Rnagp224/Uploads/Ensamble Pergola.IGS

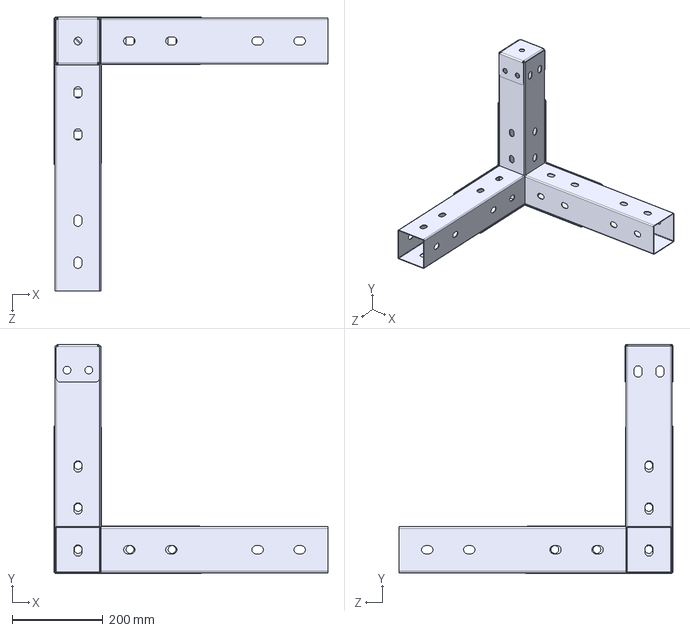
[picture p1: CAD file, 2024-05-31]
Ensamble Pergola.IGS
603.5 x 505.1 x 603.8 mm
