Rnagp224/Uploads/Agadir.STEP

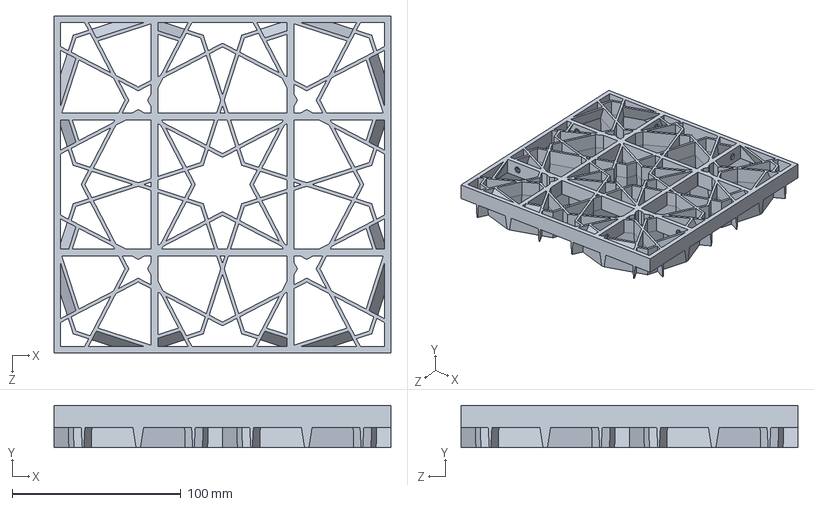
[picture p2: CAD file, 2025-08-26]
Agadir.STEP
200.0 x 25.0 x 200.0 mm
