Rnagp224/Uploads/Convexo.STEP

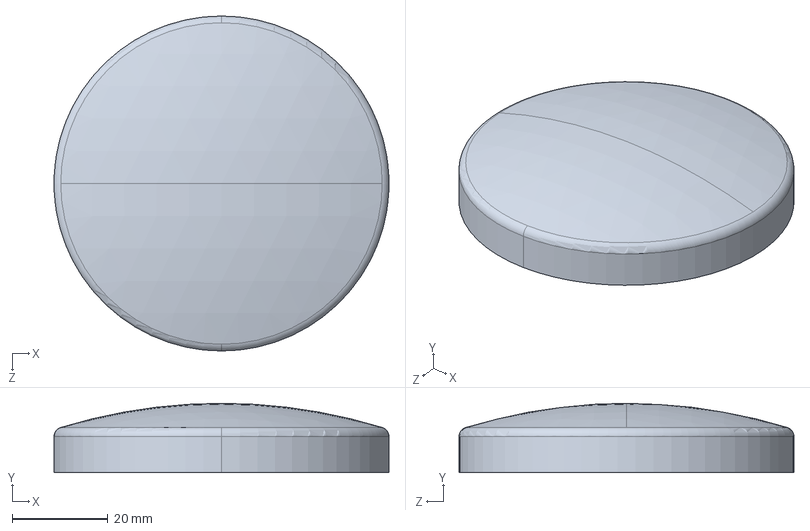
[picture p3: CAD file, 2025-03-21]
Convexo.STEP
70.0 x 14.5 x 70.0 mm
