Rnagp224/Uploads/Mesa Eaton.STEP

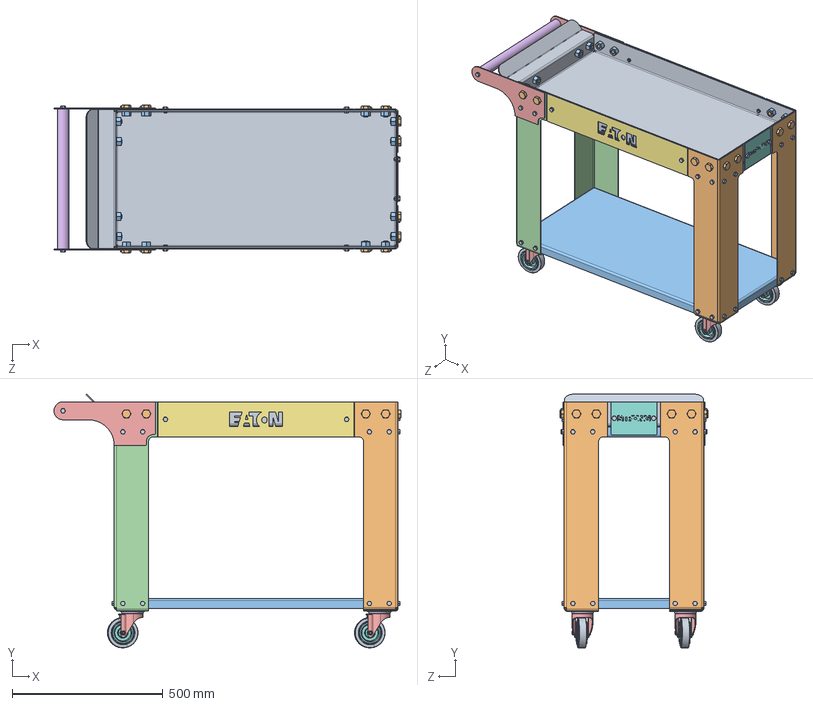
[picture p5: CAD file, 2024-09-07]
Mesa Eaton.STEP
1152.9 x 842.7 x 491.0 mm
Charola 1
Pata Eaton x 2
Charola3_Calibre 14
Top Plate x 4
Yoke x 4
Seal x 4
641028x55 x 4
Wheel 4in x 4
nut_din_985-m8x1_25-8 x 4
Charola2_Calibre 14
Pata Eaton_Trasera
MirrorPata Eaton_Trasera
Jalador x 2
Barra_Default<As Machined>
Placa Eaton x 2
Strong
hex bolt_ai_HBOLT 0.3750-16x0.5x0.5-C x 40
heavy hex finished bolt_ai_HHFBOLT 0.6250-11x1x1-N x 16
heavy hex nut_ai_HHNUT 0.6250-11-D-N x 16
hex jam nut_ai_HJNUT 0.3125-18-D-N x 6
