Rnagp224/Uploads/Mesa-18.STEP

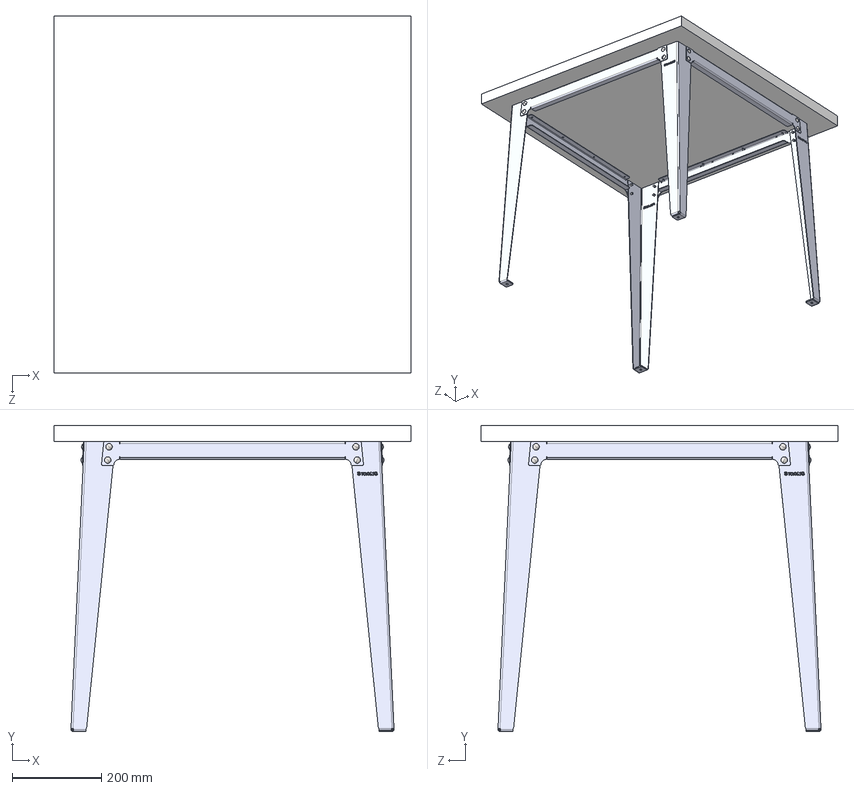
[picture p7: CAD file, 2024-07-04]
Mesa-18.STEP
800.0 x 686.0 x 800.0 mm
Largero x 4
Pata x 4
Cubierta
round head bolt_ai_RHBOLT 0.25-20x.375x.375-N x 16
