Rnagp224/Uploads/CamaLaserCut.STEP

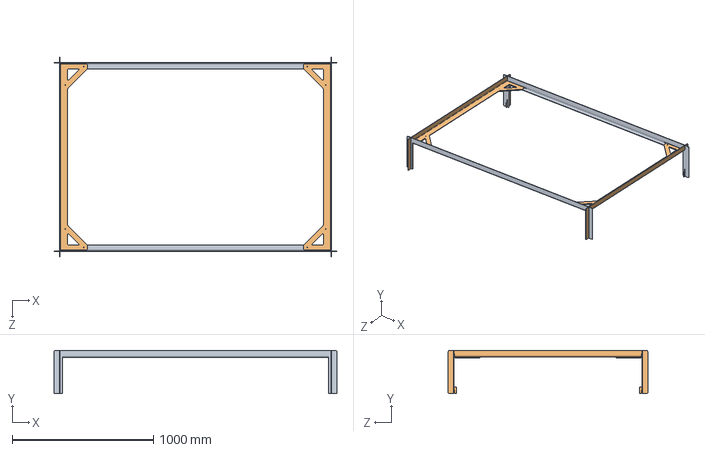
[picture p8: CAD file, 2024-07-01]
CamaLaserCut.STEP
2006.0 x 305.0 x 1416.0 mm
