Rnagp224/Uploads/Pata mesa.IGS

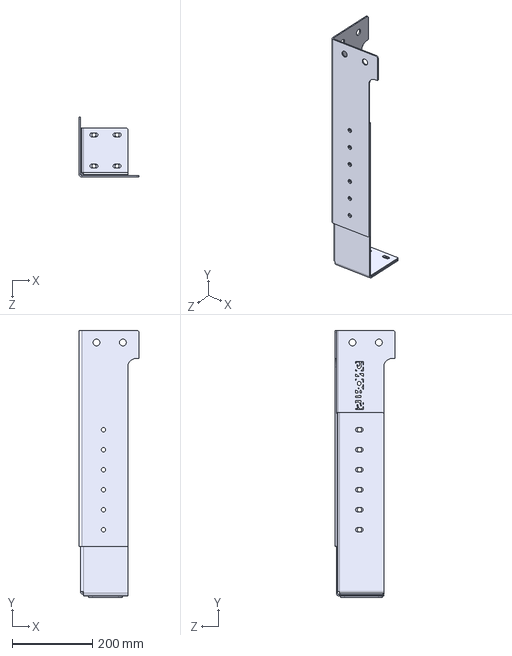
[picture p9: CAD file, 2024-05-30]
Pata mesa.IGS
150.0 x 667.3 x 150.0 mm
