Rnagp224/Uploads/(list of files, cad)

Other CAD files:
Molde Concavexo Exploded.3dm
Molde Concavexo.3dm
